Dwijvyas-9926/AVION/docs/SOURCE_MANIFEST.md

# Source manifest

This file maps every file in the team's Google Drive folder (`AVION`) to its place in this repository. Each copied file was checked against its Drive original by size and MD5 checksum.

GPS coordinates of the test sites were replaced with `[redacted]` in the flight logs before publishing. No other content was changed.

The `venv/` folder (a Python virtual environment with third-party packages) and `_pycache_/` (compiled `.pyc` files) were left out on purpose, because both are rebuilt automatically. The venv's `pyvenv.cfg` shows the Pi runs **Python 3.11.2** with system site-packages enabled.

| Drive folder | Drive file | Size | Repository path | Status |
|---|---|---|---|---|
| AVION Main codes | `config.py` | 3.4 KB | `flight_software/config.py` | Identical (MD5 verified) |
| AVION Main codes | `mission_manager.py` | 45.1 KB | `flight_software/mission_manager.py` | Identical (MD5 verified) |
| AVION Main codes | `gui.py` | 18.9 KB | `flight_software/gui.py` | Identical (MD5 verified) |
| AVION Main codes | `calibrate_hsv.py` | 17.9 KB | `flight_software/calibrate_hsv.py` | Identical (MD5 verified) |
| AVION Main codes | `flight_controller.py` | 19.5 KB | `flight_software/flight_controller.py` | Identical (MD5 verified) |
| AVION Main codes | `takeoff.py` | 5.2 KB | `tools/bench/hover_test.py` | Identical (MD5 verified) |
| AVION Main codes | `logger.py` | 0.7 KB | `flight_software/logger.py` | Identical (MD5 verified) |
| AVION Main codes | `rover.py` | 6.3 KB | `flight_software/rover.py` | Identical (MD5 verified) |
| AVION Main codes | `vision.py` | 14.3 KB | `flight_software/vision.py` | Identical (MD5 verified) |
| AVION Main codes | `main.py` | 3.2 KB | `flight_software/main.py` | Identical (MD5 verified) |
| AVION Main codes | `arm_test.py` | 13.5 KB | `tools/bench/arm_test.py` | Identical (MD5 verified) |
| AVION Main codes | `depth_test.py` | 6.6 KB | `tools/bench/depth_test.py` | Identical (MD5 verified) |
| AVION Main codes | `cam_test.py` | 3.5 KB | `tools/bench/cam_test.py` | Identical (MD5 verified) |
| AVION Main codes / gui_assets | `avion_twin.glb` | 4.73 MB | `flight_software/gui_assets/avion_twin.glb` | Identical (MD5 verified) |
| AVION Main codes / gui_assets | `three.min.js` | 607.8 KB | `flight_software/gui_assets/three.min.js` | Identical (MD5 verified) |
| AVION Main codes / gui_assets | `GLTFLoader.js` | 103.3 KB | `flight_software/gui_assets/GLTFLoader.js` | Identical (MD5 verified) |
| AVION Main codes / gui_assets | `socket.io.min.js` | 45.9 KB | `flight_software/gui_assets/socket.io.min.js` | Identical (MD5 verified) |
| AVION Main codes / gui_assets | `OrbitControls.js` | 26.7 KB | `flight_software/gui_assets/OrbitControls.js` | Identical (MD5 verified) |
| AVION Main codes / gui_assets | `gcs.html` | 66.0 KB | `flight_software/gui_assets/gcs.html` | Identical (MD5 verified) |
| AVION Main codes / gui_assets | `RoomEnvironment.js` | 3.7 KB | `flight_software/gui_assets/RoomEnvironment.js` | Identical (MD5 verified) |
| AVION Main codes / gui_assets / fonts | `jetbrains-mono-latin-400-normal.woff2` | 21.2 KB | `flight_software/gui_assets/fonts/jetbrains-mono-latin-400-normal.woff2` | Identical (MD5 verified) |
| AVION Main codes / gui_assets / fonts | `instrument-sans-latin-400-normal.woff2` | 16.9 KB | `flight_software/gui_assets/fonts/instrument-sans-latin-400-normal.woff2` | Identical (MD5 verified) |
| AVION Main codes / gui_assets / fonts | `instrument-sans-latin-500-normal.woff2` | 17.2 KB | `flight_software/gui_assets/fonts/instrument-sans-latin-500-normal.woff2` | Identical (MD5 verified) |
| AVION Main codes / gui_assets / fonts | `jetbrains-mono-latin-500-normal.woff2` | 21.8 KB | `flight_software/gui_assets/fonts/jetbrains-mono-latin-500-normal.woff2` | Identical (MD5 verified) |
| AVION Main codes / gui_assets / fonts | `instrument-sans-latin-600-normal.woff2` | 17.4 KB | `flight_software/gui_assets/fonts/instrument-sans-latin-600-normal.woff2` | Identical (MD5 verified) |
| AVION Main codes / logs | `flight_20261009_101047.log` | 75.2 KB | `flight_software/logs/flight_20261009_101047.log` | Identical except GPS coordinates replaced with `[redacted]` |
| AVION Main codes / logs | `flight_20261009_094010.log` | 7.2 KB | `flight_software/logs/flight_20261009_094010.log` | Identical (MD5 verified) |
| AVION Main codes / logs | `flight_20261008_161956.log` | 32.3 KB | `flight_software/logs/flight_20261008_161956.log` | Identical except GPS coordinates replaced with `[redacted]` |
| AVION Main codes / logs | `flight_20261008_140049.log` | 19.7 KB | `flight_software/logs/flight_20261008_140049.log` | Identical except GPS coordinates replaced with `[redacted]` |
| AVION Main codes / logs | `flight_20261008_135655.log` | 26.7 KB | `flight_software/logs/flight_20261008_135655.log` | Identical except GPS coordinates replaced with `[redacted]` |
| AVION Main codes / logs | `flight_20261008_135149.log` | 29.1 KB | `flight_software/logs/flight_20261008_135149.log` | Identical except GPS coordinates replaced with `[redacted]` |
| AVION Main codes / logs | `flight_20261008_090143.log` | 26.9 KB | `flight_software/logs/flight_20261008_090143.log` | Identical except GPS coordinates replaced with `[redacted]` |
| AVION Main codes / logs | `flight_20261008_085751.log` | 11.7 KB | `flight_software/logs/flight_20261008_085751.log` | Identical except GPS coordinates replaced with `[redacted]` |
| AVION Main codes / logs | `flight_20261008_081047.log` | 4.1 KB | `flight_software/logs/flight_20261008_081047.log` | Identical (MD5 verified) |
| AVION Main codes / logs | `flight_20261008_073305.log` | 34.6 KB | `flight_software/logs/flight_20261008_073305.log` | Identical except GPS coordinates replaced with `[redacted]` |
| AVION Main codes / logs | `flight_20261008_000239.log` | 7.6 KB | `flight_software/logs/flight_20261008_000239.log` | Identical (MD5 verified) |
| AVION Main codes / logs | `flight_20261007_235221.log` | 8.1 KB | `flight_software/logs/flight_20261007_235221.log` | Identical (MD5 verified) |
| AVION Main codes / logs | `flight_20261007_234721.log` | 7.7 KB | `flight_software/logs/flight_20261007_234721.log` | Identical (MD5 verified) |
| AVION Main codes / logs | `flight_20261007_182801.log` | 30.6 KB | `flight_software/logs/flight_20261007_182801.log` | Identical except GPS coordinates replaced with `[redacted]` |
| AVION Main codes / logs | `flight_20261007_151352.log` | 3.7 KB | `flight_software/logs/flight_20261007_151352.log` | Identical (MD5 verified) |
| AVION Main codes / logs | `flight_20261007_150304.log` | 3.3 KB | `flight_software/logs/flight_20261007_150304.log` | Identical (MD5 verified) |
| AVION Main codes / logs | `flight_20261005_161250.log` | 35.4 KB | `flight_software/logs/flight_20261005_161250.log` | Identical except GPS coordinates replaced with `[redacted]` |
| AVION Main codes / logs | `flight_20261005_160724.log` | 7.5 KB | `flight_software/logs/flight_20261005_160724.log` | Identical except GPS coordinates replaced with `[redacted]` |
| AVION Main codes / logs | `flight_20261004_181750.log` | 69.6 KB | `flight_software/logs/flight_20261004_181750.log` | Identical except GPS coordinates replaced with `[redacted]` |
| AVION Main codes / logs | `flight_20261004_181500.log` | 11.0 KB | `flight_software/logs/flight_20261004_181500.log` | Identical except GPS coordinates replaced with `[redacted]` |
| AVION Main codes / logs | `flight_20261004_135605.log` | 75.2 KB | `flight_software/logs/flight_20261004_135605.log` | Identical except GPS coordinates replaced with `[redacted]` |
| AVION Main codes / logs | `flight_20261003_165916.log` | 45.0 KB | `flight_software/logs/flight_20261003_165916.log` | Identical except GPS coordinates replaced with `[redacted]` |
| AVION Main codes / logs | `flight_20261003_163641.log` | 9.5 KB | `flight_software/logs/flight_20261003_163641.log` | Identical (MD5 verified) |
| AVION Main codes / logs | `flight_20261003_151442.log` | 15.0 KB | `flight_software/logs/flight_20261003_151442.log` | Identical except GPS coordinates replaced with `[redacted]` |
| AVION Main codes / logs | `flight_20261002_170849.log` | 13.0 KB | `flight_software/logs/flight_20261002_170849.log` | Identical (MD5 verified) |
| AVION Main codes / logs | `flight_20261002_170739.log` | 2.3 KB | `flight_software/logs/flight_20261002_170739.log` | Identical (MD5 verified) |
| AVION Main codes / logs | `flight_20261002_121026.log` | 3.0 KB | `flight_software/logs/flight_20261002_121026.log` | Identical (MD5 verified) |
| AVION Main codes / logs | `flight_20261002_120838.log` | 3.0 KB | `flight_software/logs/flight_20261002_120838.log` | Identical (MD5 verified) |
| AVION Test Codes | `Takeoff.py` | 2.4 KB | `tools/prototypes/takeoff_land.py` | Identical (MD5 verified) |
| AVION Test Codes | `arm_test.py` | 13.5 KB | `tools/bench/arm_test.py` | Identical to the copy in Main codes; stored once |
| AVION Test Codes | `depth_test.py` | 6.6 KB | `tools/bench/depth_test.py` | Identical to the copy in Main codes; stored once |
| AVION Test Codes | `cam_test.py` | 3.5 KB | `tools/bench/cam_test.py` | Identical to the copy in Main codes; stored once |
| AVION Test Codes | `takefwdlnd.py` | 2.4 KB | `tools/prototypes/takeoff_forward_land.py` | Identical (MD5 verified) |
| AVION Test Codes | `yawauto.py` | 3.5 KB | `tools/prototypes/yaw_auto.py` | Identical (MD5 verified) |
| AVION Test Codes | `paydel2.py` | 3.5 KB | `tools/prototypes/payload_delivery.py` | Identical (MD5 verified) |
| AVION Test Codes | `hook.py` | 0.7 KB | `tools/prototypes/hook_servo_test.py` | Identical (MD5 verified) |
| AVION Test Codes | `imgcap.py` | 0.4 KB | `tools/prototypes/image_capture.py` | Identical (MD5 verified) |
| AVION Gallery | `IMG_5631.JPG` | 5.75 MB | `docs/images/avion_side_view.jpg` | Resized to 2400 px, metadata (incl. GPS) removed |
| AVION Gallery | `IMG_5629.JPG` | 6.00 MB | `docs/images/avion_top_view.jpg` | Resized to 2400 px, metadata (incl. GPS) removed |
| AVION Gallery | `IMG_5630 (1).JPG` | 6.13 MB | `docs/images/avion_three_quarter_view.jpg` | Resized to 2400 px, metadata (incl. GPS) removed — duplicate of IMG_5630.JPG |
| AVION Gallery | `IMG_5630.JPG` | 6.13 MB | `docs/images/avion_three_quarter_view.jpg` | Resized to 2400 px, metadata (incl. GPS) removed |
| AVION Gallery | `reload_popup_step2.png` | 219.3 KB | `docs/images/gcs_reload_prompt.png` | Identical (MD5 verified) |
| AVION Gallery | `IMG_7617.MOV` | 195.82 MB | — | Not included (by choice) |
| AVION CAD Files | `AVION ASSEMBLY.step` | 43.33 MB | `cad/avion_assembly.step` | Identical (size verified via release upload) |
| AVION CAD Files | `plate_lidar.stl` | 27.5 KB | `cad/avionics/lidar_mount_plate.stl` | Identical (MD5 verified) |
| AVION CAD Files | `hook upper cap.stl` | 189.1 KB | `cad/payload/payload_hook_upper_cap.stl` | Identical (MD5 verified) |
| AVION CAD Files | `payload hook.stl` | 231.8 KB | `cad/payload/payload_hook.stl` | Identical (MD5 verified) |
| AVION CAD Files | `Ras_pix_top.stl` | 492.8 KB | `cad/avionics/rpi_pixhawk_stack_top.stl` | Identical (MD5 verified) |
| AVION CAD Files | `Ras_pix_Bottom.stl` | 655.4 KB | `cad/avionics/rpi_pixhawk_stack_bottom.stl` | Identical (MD5 verified) |
| AVION CAD Files | `rpi_pixhawk_mount.stl` | 55.9 KB | `cad/avionics/rpi_pixhawk_mount_plate.stl` | Identical (MD5 verified) |
| AVION CAD Files | `final L mount updated.stl` | 259.0 KB | `cad/frame/arm_l_mount.stl` | Identical (MD5 verified) |
| AVION CAD Files | `Body6.3mf` | 255.9 KB | `cad/frame/body_plate.3mf` | Identical (MD5 verified) |
| AVION CAD Files | `RS3_cradle (2) v2.step` | 316.9 KB | `cad/avionics/rs3_camera_cradle_v2.step` | Identical (MD5 verified) |
| AVION CAD Files | `clamp_arm.step` | 154.8 KB | `cad/frame/tube_clamp_arm.step` | Identical (MD5 verified) |
| AVION CAD Files | `clamp_cap.step` | 30.5 KB | `cad/frame/tube_clamp_cap.step` | Identical (MD5 verified) |
| AVION CAD Files | `Body6.stl` | 72.3 KB | `cad/frame/body_plate.stl` | Identical (MD5 verified) |
| AVION CAD Files | `PG1_guard_ring.stl` | 91.2 KB | `cad/frame/pg1_guard_ring.stl` | Identical (MD5 verified) |
| AVION CAD Files | `ET3_tray_arm_aligned.stl` | 381.5 KB | `cad/frame/et3_center_tray.stl` | Identical (MD5 verified) |
| AVION CAD Files | `PG2_collar_body.stl` | 158.8 KB | `cad/frame/pg2_collar_body.stl` | Identical (MD5 verified) |
| AVION CAD Files | `rail plate.stl` | 179.3 KB | `cad/avionics/rail_mount_plate.stl` | Identical (MD5 verified) |
| AVION CAD Files | `PG3_collar_cap.stl` | 55.1 KB | `cad/frame/pg3_collar_cap.stl` | Identical (MD5 verified) |
| AVION CAD Files | `bottom plate updated.stl` | 232.7 KB | `cad/frame/bottom_plate.stl` | Identical (MD5 verified) |
| AVION CAD Files | `Untitled.stl` | 462.0 KB | `cad/frame/landing_foot.stl` | Identical (MD5 verified) |
| AVION CAD Files | `final updated T mount.stl` | 454.6 KB | `cad/frame/tube_t_joint.stl` | Identical (MD5 verified) |
| (top level) | `Avion Digital Simulator.html` | 6.37 MB | `simulator/avion_digital_simulator.html` | Identical (size verified via release upload) |
| (top level) | `AVION Presentation.pptx` | 9.32 MB | `docs/avion_presentation.pptx` | Identical (size verified via release upload) |
| (top level) | `avion description video.mp4` | 69.76 MB | [Release v1.0.0](https://github.com/Dwijvyas-9926/AVION/releases/tag/v1.0.0) | Release asset (too large to keep in git history) |
| (top level) | `AVION ASSEMBLY CAD.step` | 43.33 MB | `cad/avion_assembly.step` | Duplicate of `AVION ASSEMBLY.step`; stored once |
| AVION Main codes / venv | `pyvenv.cfg` | 0.2 KB | — | Excluded: Python virtual environment (rebuilt from `requirements.txt`) |
