Dwijvyas-9926/AVION/cad/avionics/rail_mount_plate.stl

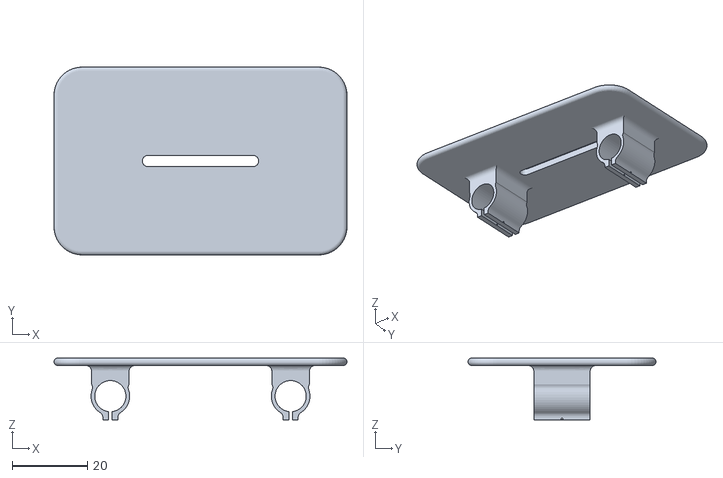
[picture p34: CAD file, 2026-10-31]
cad/avionics/rail_mount_plate.stl
78.0 x 50.0 x 16.5
