Dwijvyas-9926/AVION/cad/frame/pg2_collar_body.stl

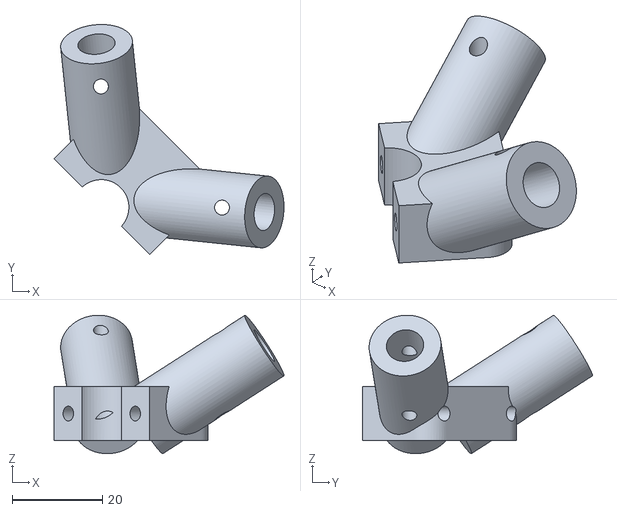
[picture p35: CAD file, 2026-10-31]
cad/frame/pg2_collar_body.stl
51.0 x 51.0 x 30.7
