Dwijvyas-9926/AVION/cad/payload/payload_hook_upper_cap.stl

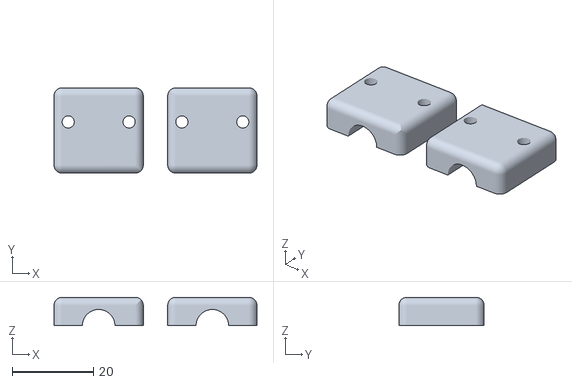
[picture p36: CAD file, 2026-10-31]
cad/payload/payload_hook_upper_cap.stl
50.0 x 21.0 x 7.00
