Dwijvyas-9926/AVION/cad/avionics/rs3_camera_cradle_v2.step

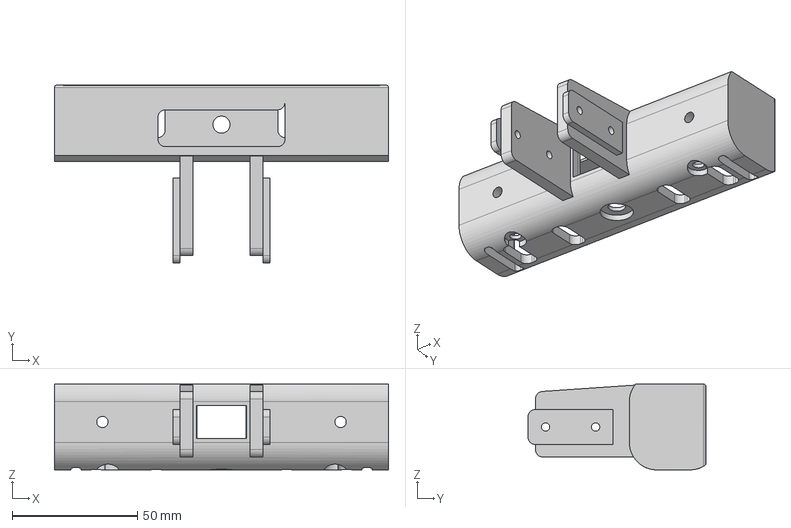
[picture p37: CAD file, 2026-10-31]
cad/avionics/rs3_camera_cradle_v2.step
133.2 x 71.0 x 34.2 mm
