Dwijvyas-9926/AVION/cad/frame/body_plate.3mf

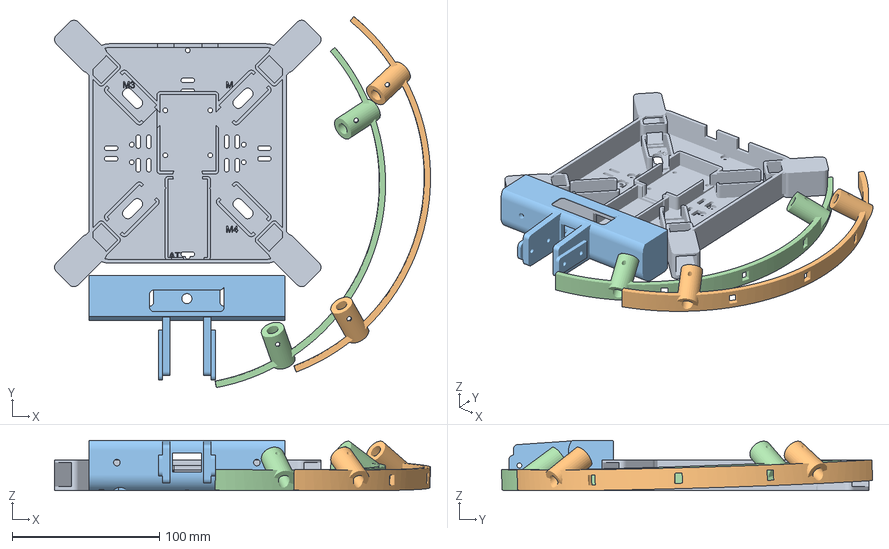
[picture p38: CAD file, 2026-10-31]
cad/frame/body_plate.3mf
255.2 x 251.9 x 34.2 mm
ET3_tray_arm_aligned.stl
PG1_guard_ring.stl x 2
RS3_cradle (2) v2.step
