Dwijvyas-9926/AVION/cad/payload/payload_hook.stl

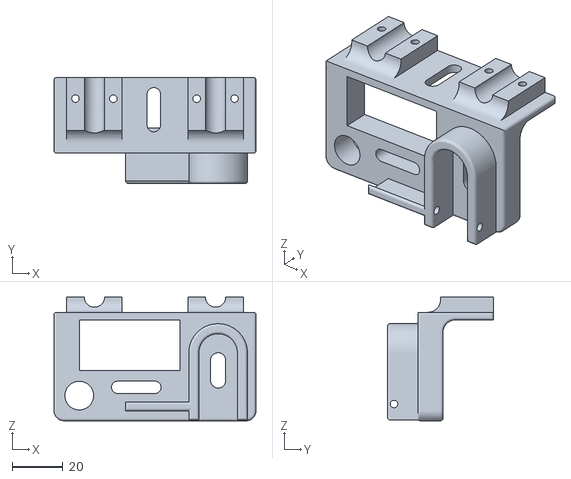
[picture p39: CAD file, 2026-10-31]
cad/payload/payload_hook.stl
80.0 x 42.0 x 49.0
