Dwijvyas-9926/AVION/cad/avionics/rpi_pixhawk_stack_bottom.stl

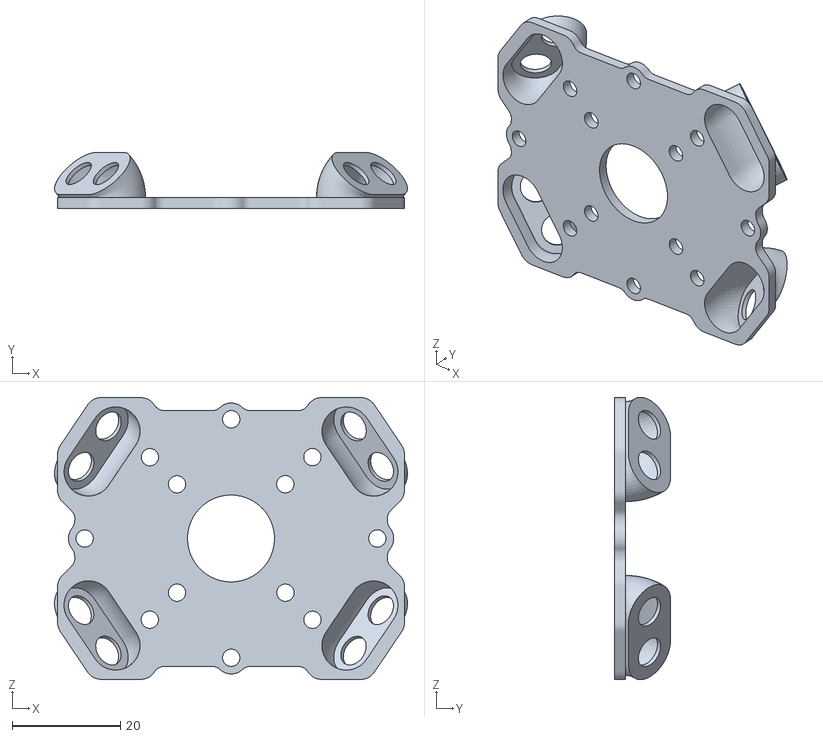
[picture p40: CAD file, 2026-10-31]
cad/avionics/rpi_pixhawk_stack_bottom.stl
65.1 x 10.4 x 52.1
