Dwijvyas-9926/AVION/cad/frame/tube_clamp_cap.step

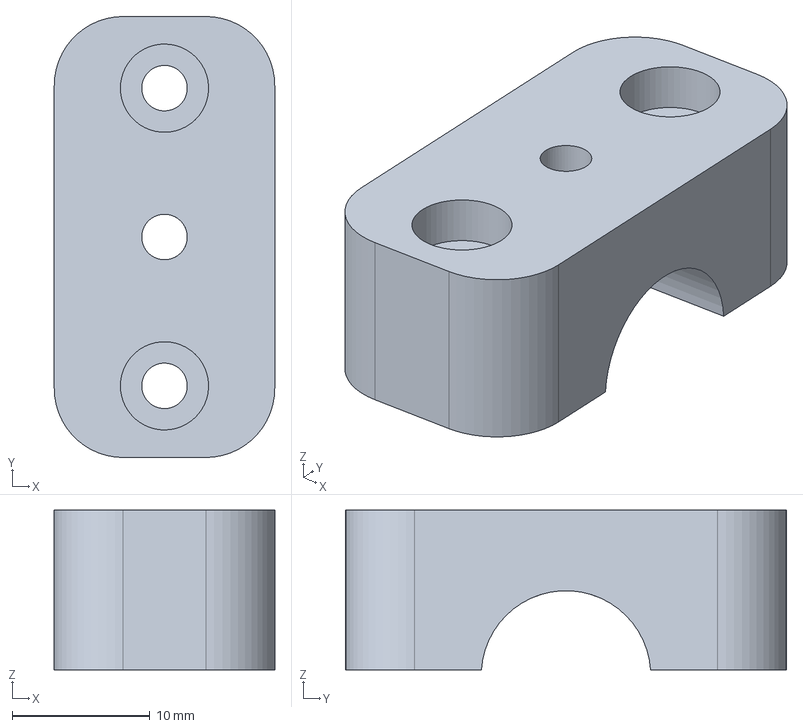
[picture p41: CAD file, 2026-10-31]
cad/frame/tube_clamp_cap.step
16.0 x 32.0 x 11.6 mm
