Dwijvyas-9926/AVION/cad/avionics/rpi_pixhawk_mount_plate.stl

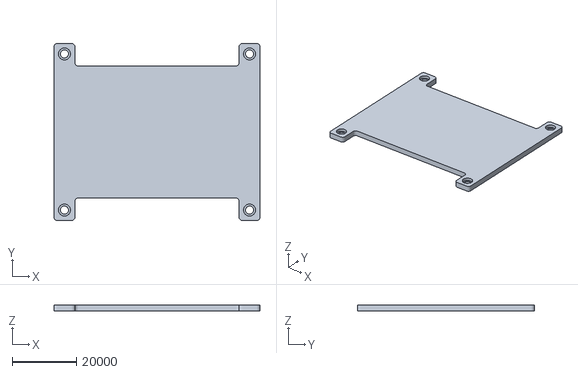
[picture p42: CAD file, 2026-10-31]
cad/avionics/rpi_pixhawk_mount_plate.stl
64000.0 x 55000.0 x 2000.0
