Dwijvyas-9926/AVION/cad/frame/arm_l_mount.stl

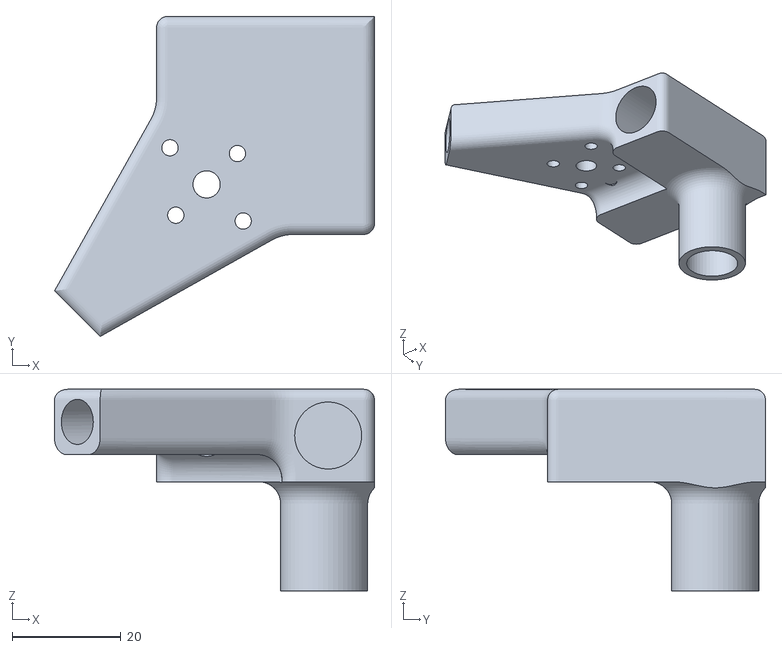
[picture p43: CAD file, 2026-10-31]
cad/frame/arm_l_mount.stl
58.7 x 58.7 x 37.0
