Dwijvyas-9926/AVION/cad/avionics/lidar_mount_plate.stl

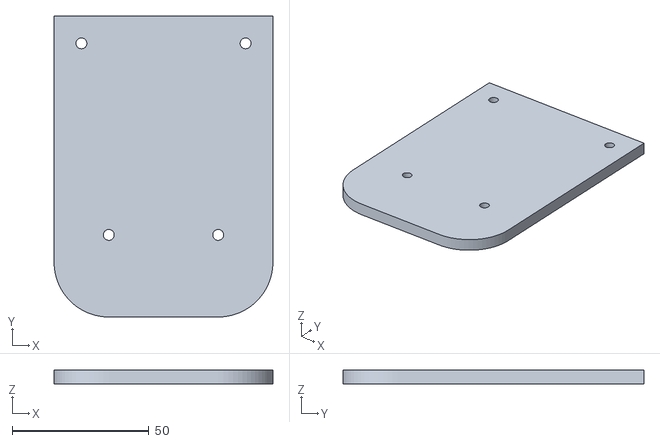
[picture p44: CAD file, 2026-10-31]
cad/avionics/lidar_mount_plate.stl
80.0 x 110.0 x 5.00
