Dwijvyas-9926/AVION/cad/frame/pg1_guard_ring.stl

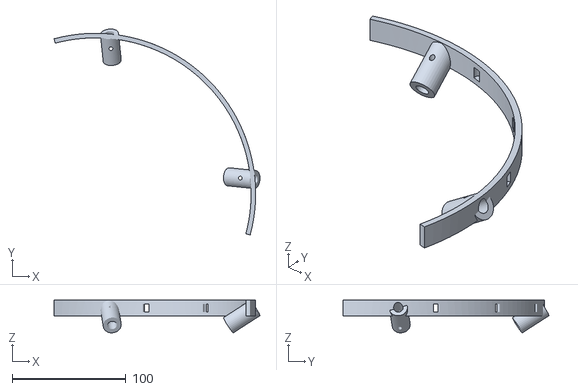
[picture p45: CAD file, 2026-10-31]
cad/frame/pg1_guard_ring.stl
181.3 x 181.3 x 28.8
