Dwijvyas-9926/AVION/cad/avionics/rpi_pixhawk_stack_top.stl

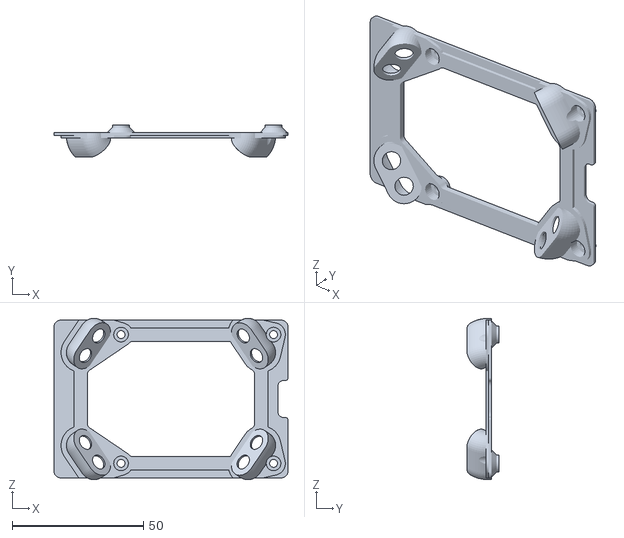
[picture p46: CAD file, 2026-10-31]
cad/avionics/rpi_pixhawk_stack_top.stl
89.0 x 12.4 x 61.4
