Dwijvyas-9926/AVION/cad/frame/tube_clamp_arm.step

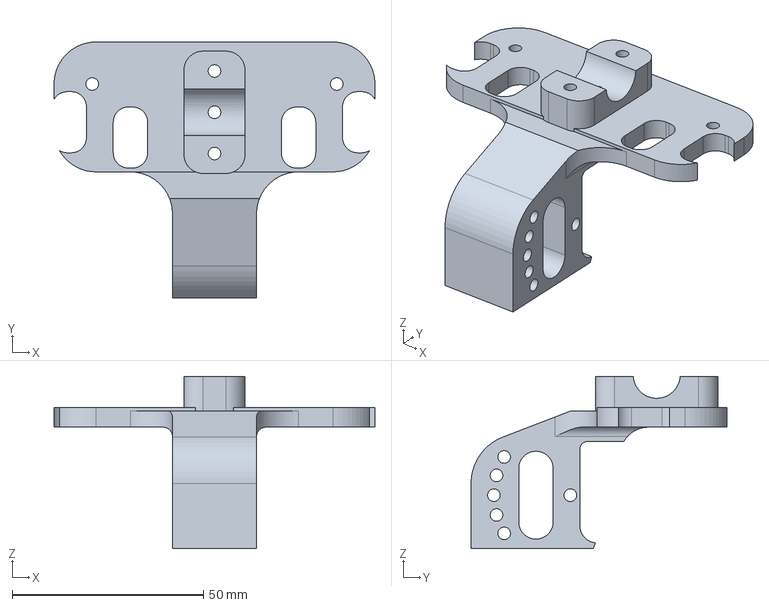
[picture p47: CAD file, 2026-10-31]
cad/frame/tube_clamp_arm.step
84.0 x 67.0 x 45.1 mm
