Dwijvyas-9926/AVION/cad/frame/bottom_plate.stl

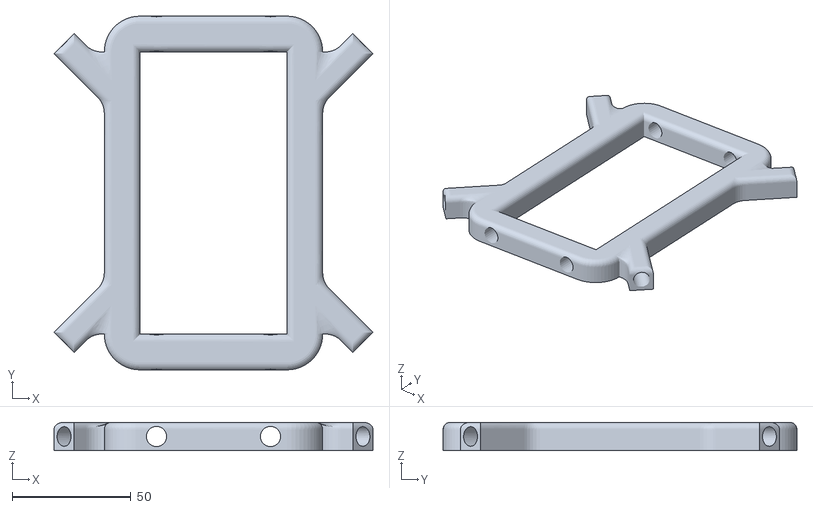
[picture p48: CAD file, 2026-10-31]
cad/frame/bottom_plate.stl
134.3 x 149.0 x 12.0
