Dwijvyas-9926/AVION/cad/frame/tube_t_joint.stl

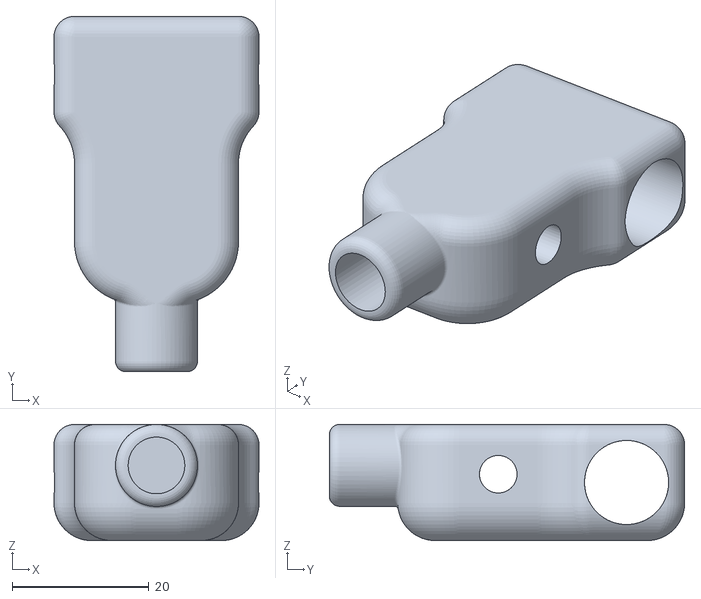
[picture p49: CAD file, 2026-10-31]
cad/frame/tube_t_joint.stl
30.0 x 52.0 x 17.0
