Dwijvyas-9926/AVION/cad/frame/landing_foot.stl

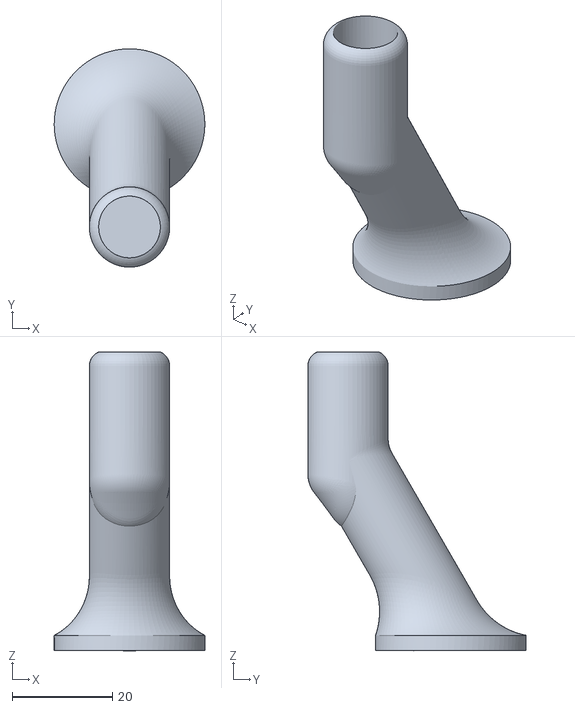
[picture p50: CAD file, 2026-10-31]
cad/frame/landing_foot.stl
30.0 x 43.5 x 59.6
