Dwijvyas-9926/AVION/cad/frame/pg3_collar_cap.stl

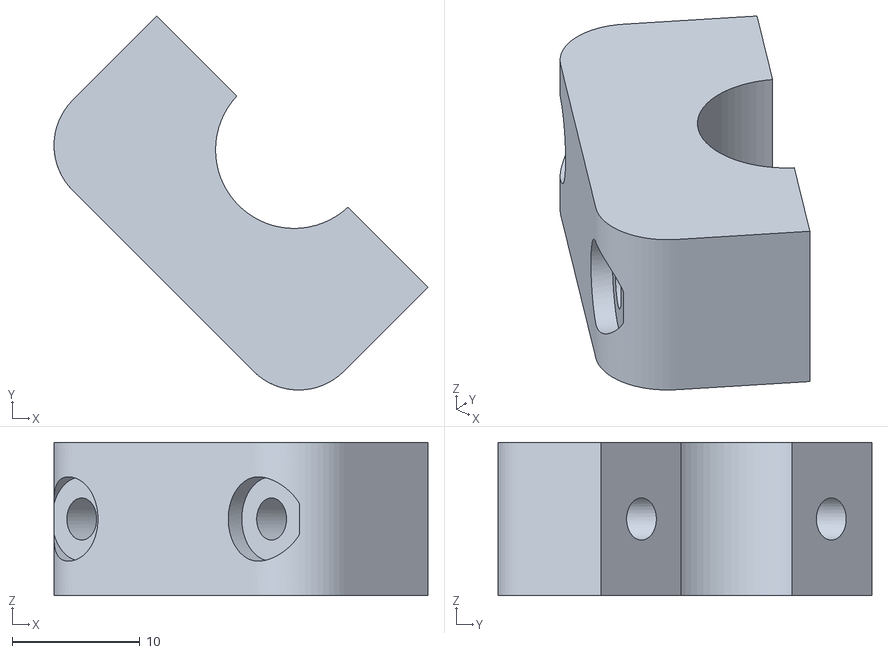
[picture p51: CAD file, 2026-10-31]
cad/frame/pg3_collar_cap.stl
29.3 x 29.3 x 12.0
