Dwijvyas-9926/AVION/cad/frame/et3_center_tray.stl

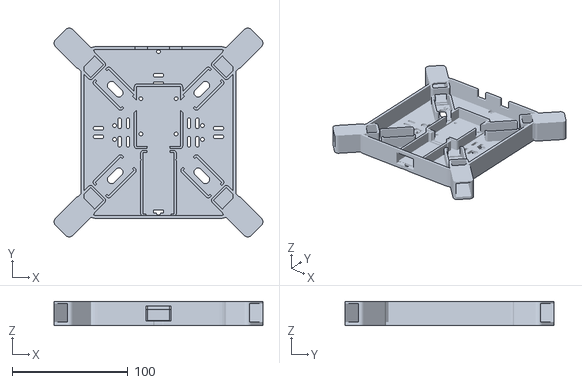
[picture p52: CAD file, 2026-10-31]
cad/frame/et3_center_tray.stl
181.0 x 181.0 x 21.0
