Dwijvyas-9926/AVION/(list of files, cad)

Other CAD files:
cad/avion_assembly.step
cad/frame/body_plate.stl
