Dwijvyas-9926/AVION/(commit log)

2026-10-31 Add AVION flight software, ground station, CAD, tools and docs
    Imports the project files from the team Drive folder into a structured
    repository:
    - flight_software/: Raspberry Pi mission code (state machine, DroneKit
    wrapper, RealSense vision, rover mode, Flask/Socket.IO ground station
    with offline 3D digital twin assets) and 30 test-flight logs
    - tools/bench and tools/prototypes: hardware bring-up tests and early
    pymavlink experiments (duplicates from the test folder de-duplicated)
    - cad/: STL, STEP and 3MF parts with a parts index
    - media/photos: drone photos, resized and stripped of EXIF/GPS metadata
    - README with architecture, mission sequence, setup, config reference
    and known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
    [Body6.3mf, Body6.stl, ET3_tray_arm_aligned.stl, PG1_guard_ring.stl, PG2_collar_body.stl, PG3_collar_cap.stl, Ras_pix_Bottom.stl, Ras_pix_top.stl]
2026-10-31 Reorganise CAD by subsystem, add source manifest and naming cleanup
    - Group CAD parts into frame/, payload/ and avionics/ with consistent
    lowercase descriptive names (original Drive names kept in cad/README)
    - Identify Untitled.stl as the landing-gear foot; add a rendered
    overview of all printable parts
    - Move images to docs/images/
    - Add docs/SOURCE_MANIFEST.md mapping every Drive file to its repo path,
    verified by MD5
    - Add .gitattributes (binary assets, vendored JS excluded from stats)
    - README: new layout, Python 3.11.2 / system-site-packages venv note,
    Large files section
    Claude-Session: https://claude.ai/code/session_012w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
    [arm_l_mount.stl, body_plate.3mf, body_plate.stl, bottom_plate.stl, et3_center_tray.stl, landing_foot.stl, lidar_mount_plate.stl, payload_hook.stl]
2026-11-01 Add digital simulator, presentation and full assembly STEP
    - simulator/avion_digital_simulator.html with README and screenshot
    - docs/avion_presentation.pptx
    - cad/avion_assembly.step (full airframe assembly)
    - README Large files section and source manifest updated; description
    video lives in the v1.0 release, MOV stays on Drive (over 100 MB)
    Claude-Session: https://claude.ai/code/session_012wyKQVxe2rp66Zw1sSpyLK
    [avion_assembly.step]
2026-11-01 Fix .gitignore hiding docs/images; add missing overview images
    The images/ rule (meant for image_capture.py output) also matched
    docs/images/, so the CAD overview and simulator screenshot referenced
    by the READMEs were never committed. Anchor the rule to the capture
    output locations only.
    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
2026-11-01 Final polish of documentation and layout
    - README: realigned system and mission diagrams, complete repository
    tree, new Digital simulator section, matched photo heights, correct
    counts (28 logs, 19 CAD parts in 20 files)
    - Drop IMG_7617.MOV from docs (not included by choice)
    - CAD overview image with transparent background for dark mode
    - Minor wording fixes in tools/README
    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
